zzztg/Design-of-a-Digital-Signal-Source-based-on-a-Single-chip-Microcomputer/软件工程/ad9834_test1/软件设计文档.md

# 双路同步 DDS 数字信号源 — 软件设计文档

> 基于 STM32F407VET6 + 两片 AD9834  
> 最后更新: 2026-06-03

---

## 目录

1. [系统概述](#1-系统概述)
2. [硬件资源映射](#2-硬件资源映射)
3. [软件架构](#3-软件架构)
4. [数据结构设计](#4-数据结构设计)
5. [模块详细设计](#5-模块详细设计)
6. [主循环流程](#6-主循环流程)
7. [双路同步机制](#7-双路同步机制)
8. [接口说明](#8-接口说明)

---

## 1. 系统概述

### 1.1 功能定义

双通道独立可调的数字信号源，支持：

- **频率**：1 Hz ~ 10 MHz，步进 1 Hz ~ 1 MHz（按位编辑）
- **幅值**：±18 V（用 mV 表示），步进 10 mV ~ 10 V
- **相位**：0.0° ~ 360.0°，精度 0.1°
- **波形**：正弦波、三角波、方波
- **通道模式**：单独调 A、单独调 B、同时调 AB

### 1.2 硬件拓扑

```
                        ┌─ AD9834_A (CS_A = PB12)
SPI2 (共享总线) ────────┼─ AD9834_B (CS_B = PB11)
                        └─ DAC      (CS_DAC = PB10)
                               ↑ 幅值控制（待实现）

SYNC_RESET (PB14) ──────── 两片 AD9834 的 RESET 引脚（共用）
```

AD9834 两片共用 SPI2 总线，通过各自的 CS 片选区分。  
SYNC_RESET 引脚同时接两片 AD9834 的硬件 RESET，用于同步启动。

---

## 2. 硬件资源映射

| 外设 | 功能 | 引脚 | CubeMX 配置 |
|---|---|---|---|
| **SPI2** | AD9834 + DAC 通信 | PB13(SCK), PB15(MOSI) | 主机、全双工 |
| **TIM1** | 编码器 3 — 相位调节 | PE9(CH1), PE11(CH2) | 编码器模式 |
| **TIM2** | 编码器 1 — 频率调节 | PA0(CH1), PA1(CH2) | 编码器模式 |
| **TIM3** | 编码器 2 — 幅值调节 | PB4(CH1), PB5(CH2) | 编码器模式 |
| **USART1** | printf 调试输出 | PA9(TX), PA10(RX) | 异步 115200 |

### GPIO 引脚分配

| 标签 | 引脚 | 方向 | 用途 |
|---|---|---|---|
| CS_A | PB12 | 输出 | AD9834_A 片选 |
| CS_B | PB11 | 输出 | AD9834_B 片选 |
| CS_DAC | PB10 | 输出 | DAC 片选 |
| SYNC_RESET | PB14 | 输出 | 两片 AD9834 同步复位 |
| WAVE_SEL_A | PC10 | 输出 | A 路波形选择（方波=高） |
| WAVE_SEL_B | PC11 | 输出 | B 路波形选择（方波=高） |
| KEY_ENC1 | PD0 | 输入 | 频率编码器按键 |
| KEY_ENC2 | PD1 | 输入 | 幅值编码器按键 |
| KEY_ENC3 | PD2 | 输入 | 相位编码器按键 |
| KEY_SW1 | PD3 | 输入 | 通道切换 |
| KEY_SW2 | PD4 | 输入 | 波形切换 |

---

## 3. 软件架构

### 3.1 分层结构

```
┌──────────────────────────────────────┐
│            main.c (主循环)            │  ← 应用层
│  ┌──────────┬──────────┬──────────┐   │
│  │ 编码器驱动│ 按键驱动  │ 状态管理  │   │
│  └────┬─────┴────┬─────┴────┬─────┘   │
│       │          │          │         │
│  ┌────▼──────────▼──────────▼─────┐   │
│  │       UpdateDDS / UpdateAmp     │   │  ← 硬件更新层
│  └────┬──────────┬──────────┬─────┘   │
├───────┼──────────┼──────────┼─────────┤
│  ┌────▼────┐ ┌───▼────┐ ┌──▼──────┐  │  ← BSP/驱动层
│  │ AD9834  │ │  DAC   │ │   HAL   │  │
│  │ BSP驱动 │ │ (待实现)│ │  库函数  │  │
│  └─────────┘ └────────┘ └─────────┘  │
└──────────────────────────────────────┘
```

### 3.2 设计思想

**数据驱动的脏标记机制**：

```
旋钮/按键  →  修改 g_state (内存)  →  置脏标记
                                          ↓
主循环 Step5  →  检查脏标记  →  批量同步到硬件
```

- 人机交互只修改内存中的 `g_state`，不直接操作硬件
- 脏标记记录哪些参数被修改过
- 每轮循环末尾统一同步硬件，避免频繁 SPI 通信

---

## 4. 数据结构设计

### 4.1 核心结构体层次

```
system_state_t  (全局状态)
├── selected_ch     目标通道 (A/B/BOTH)
├── wave_type       当前波形
├── ch_a            通道 A 参数
│   ├── frequency_hz   频率 (Hz)
│   ├── amplitude_mv   幅值 (mV)
│   └── phase_x10      相位 (×0.1°)
├── ch_b            通道 B 参数 (同上)
├── digit_idx[3]    三个编码器当前编辑位
│   ├── [0] 频率 digit
│   ├── [1] 幅值 digit
│   └── [2] 相位 digit
└── flags           脏标记
    ├── freq_dirty    频率已修改
    ├── amp_dirty     幅值已修改
    ├── phase_dirty   相位已修改
    └── wave_dirty    波形已修改
```

### 4.2 编码器数据结构

```c
typedef struct {
    TIM_HandleTypeDef *tim;     // 绑定的定时器
    int16_t last_counter;       // 上次采样计数值
} encoder_t;
```

### 4.3 按键数据结构

```c
typedef struct {
    uint16_t pin;               // GPIO 引脚
    GPIO_TypeDef *port;         // GPIO 端口
    btn_state_t state;          // 消抖状态 (空闲/消抖中/已按下)
    uint32_t last_tick;         // 进入消抖状态的时间戳
} button_t;
```

### 4.4 枚举定义

| 枚举 | 值 | 含义 |
|---|----|---|
| `TARGET_CH_A` | 0 | 仅调节通道 A |
| `TARGET_CH_B` | 1 | 仅调节通道 B |
| `TARGET_CH_BOTH` | 2 | 同时调节两路 |
| `AD9834_WaveSine` | 0 | 正弦波 |
| `AD9834_WaveTriangle` | 1 | 三角波 |
| `AD9834_WaveSineWithSquare` | 2 | 方波 |
| `BTN_IDLE` | 0 | 按键空闲 |
| `BTN_DEBOUNCE` | 1 | 按键消抖中 |
| `BTN_PRESSED` | 2 | 按键已按下 |

---

## 5. 模块详细设计

### 5.1 编码器读取 (`Encoder_ReadDelta`)

**原理**：定时器配置为编码器模式后，计数器会随旋钮转动自动增减。

```
输入: encoder_t *enc
输出: +1(正转一格), -1(反转一格), 0(无转动)

流程:
  1. current = TIM->CNT            // 读当前计数值
  2. raw = current - last_counter  // 计算差值
  3. 更新 last_counter = current
  4. 16位回绕修正 (±65536)
  5. 死区处理: |raw| < 2 → 0      // 过滤抖动
  6. 归一化: raw > 0 → +1, else → -1
```

### 5.2 按键消抖 (`Button_Scan`)

使用三态状态机，每轮主循环调用一次。

```
状态图:

     ┌──────────────────────────────────────┐
     │                                       │
     ▼    (检测到按下)     (10ms后仍按下)     │
  IDLE ──────────────→ DEBOUNCE ──────────→ PRESSED
     ↑                    │                    │
     │    (抖动释放)       │                    │  (检测到释放)
     └────────────────────┘                    │
              (回到 IDLE)                      │
                                               ▼
                                          触发 EVT_PRESS
                                          回到 IDLE
```

**防抖动设计**：进入 DEBOUNCE 后记录当前 tick，满 10ms 再确认。期间如果电平变高（释放），认为是抖动，退回 IDLE。

### 5.3 按位编辑 (`AdjustFrequency/Amplitude/Phase`)

**按位编辑概念**：每个参数有多个"位"（digit），旋钮每转一格，只改变选中位的值。

```
频率 digit 与步进对应：
  digit 0 → 1 Hz       digit 4 → 10 kHz
  digit 1 → 10 Hz      digit 5 → 100 kHz
  digit 2 → 100 Hz     digit 6 → 1 MHz
  digit 3 → 1 kHz

示例：
  当前频率 = 1,234,567 Hz  digit = 3 (kHz位)  正转 1 格
  → 1,234,567 + 1,000 = 1,235,567 Hz

  当前频率 = 1,999,999 Hz  digit = 5 (100kHz位)  正转 1 格
  → 1,999,999 + 100,000 = 2,099,999 Hz  (自动进位)
```

**幅值 digit**：0=10mV, 1=100mV, 2=1V, 3=10V  
**相位 digit**：0=0.1°, 1=1°, 2=10°, 3=100°

每次调整后做限幅检查，防止越界。

### 5.4 通道屏蔽机制

主循环中通过比特位掩码决定哪些通道响应调节：

```c
// selected_ch → 掩码
BOTH (2) → 掩码 = 0x03   (bit0=A路, bit1=B路)
CH_A (0) → 掩码 = 0x01   (仅 A 路)
CH_B (1) → 掩码 = 0x02   (仅 B 路)

if (mask & 0x01) { /* 调 A 路的参数 */ }
if (mask & 0x02) { /* 调 B 路的参数 */ }
```

### 5.5 DAC 幅值控制（伪代码）

当前为占位注释，待具体 DAC 型号确定后实现：

```
幅值映射: 0~18000mV → 12bit DAC 值 0~4095
  dac_value = abs(amplitude_mv) × 4095 / 18000

通信方式: 共用 SPI2，片选 CS_DAC (PB10)

极性控制: 振幅为负时切换 PGA 极性引脚
  POL_x = (amplitude_mv < 0) ? SET : RESET
```

---

## 6. 主循环流程

```
系统启动
  │
  ├─ HAL_Init()
  ├─ SystemClock_Config()         // 168MHz
  ├─ MX_GPIO_Init()               // GPIO 初始化
  ├─ MX_SPI2_Init()               // SPI 初始化 (21 MBit/s)
  ├─ MX_USART1_UART_Init()        // 串口 (printf)
  ├─ MX_TIM1_Init() ~ MX_TIM3_Init()  // 编码器定时器
  │
  ├─ AD9834_Init()                // 两片 AD9834
  ├─ 启动 TIM 编码器模式
  ├─ 设置系统初始状态
  ├─ UpdateDDS()                  // 第一次同步写入
  │
  └─ while(1) 主循环 ──────────────────────┐
       │                                     │
       ├─ Step1: 读三个编码器增量             │
       │   df = Encoder_ReadDelta(g_enc_freq)│
       │   da = Encoder_ReadDelta(g_enc_amp) │
       │   dp = Encoder_ReadDelta(g_enc_phase)│
       │                                     │
       ├─ Step2: 编码器按键 → 切换编辑位       │
       │   digit_idx[i] = (digit_idx[i]+1)%N  │
       │                                     │
       ├─ Step3: 独立按键                    │
       │   KEY_SW1 → 切换通道 (A/B/BOTH)     │
       │   KEY_SW2 → 切换波形 (Sin/Tri/Sqr)  │
       │                                     │
       ├─ Step4: 旋转 → 调参                 │
       │   if (mask & ch) AdjustParam(...)   │
       │   同时置相应的脏标记                  │
       │                                     │
       ├─ Step5: 硬件同步                    │
       │   UpdateDDS(&g_state)              │
       │   UpdateAmplitude(&g_state)         │
       │                                     │
       └─ HAL_Delay(10) ← 每 10ms 一圈        │
         (约 100 Hz 轮询频率)                  │
                                              │
         └────────────────────────────────────┘
```

---

## 7. 双路同步机制

### 7.1 为什么需要同步

两片 AD9834 各自独立工作。如果没有同步机制，各自从随机相位开始输出，两路信号之间会有不确定的相位差。

### 7.2 同步方法

利用 AD9834 的 **硬件 RESET 引脚**（两片共用 SYNC_RESET）：

```
时间轴:

  SYNC_RESET ────────┬── 高电平 ──┬── 低电平 ──────────
                     │            │
  AD9834_A 状态    停止(相位=0)  开始输出
  AD9834_B 状态    停止(相位=0)  开始输出 (同时!)
                     │            │
                     │  在此区间  │
                     │  写入频率  │
                     │  写入相位  │
                     │  写入波形  │
```

### 7.3 代码实现

```c
void UpdateDDS(system_state_t *state)
{
    // 没有任何更新需要 → 跳过
    if (!state->flags.freq_dirty && !state->flags.phase_dirty && !state->flags.wave_dirty)
        return;

    // Step 1: 拉高 SYNC_RESET，两片同时停止，相位累积器归零
    HAL_GPIO_WritePin(SYNC_RESET_GPIO_Port, SYNC_RESET_Pin, GPIO_PIN_SET);

    // Step 2: 通过 SPI 分别写入两片 AD9834
    if (state->flags.wave_dirty)  { /* 写波形到 A 和 B */ }
    if (state->flags.freq_dirty)  { /* 写频率到 A 和 B */ }
    if (state->flags.phase_dirty) { /* 写相位到 A 和 B */ }

    // Step 3: 拉低 SYNC_RESET，两片同时从相位 0 开始输出
    HAL_GPIO_WritePin(SYNC_RESET_GPIO_Port, SYNC_RESET_Pin, GPIO_PIN_RESET);
}
```

### 7.4 同步时机

仅在频率或相位发生变化时触发同步。波形切换不影响相位累积器，但为了实现统一管理，当前实现在任意 DDS 参数变化时都做同步。

---

## 8. 接口说明

### 8.1 BSP 驱动接口 (`BSP/ad9834.h`)

参考 [ad9834.h](../BSP/ad9834.h)。

| 函数 | 参数 | 说明 |
|---|---|---|
| `AD9834_Init` | self, hspi, cs_pin, cs_port | 初始化 AD9834 实例 |
| `AD9834_SetReset` | self, reset | 软件复位/释放 |
| `AD9834_SetFrequency` | self, freg, frequency | 写频率寄存器 |
| `AD9834_SetPhase` | self, preg, angle | 写相位寄存器 |
| `AD9834_SelectFrequencyRegOutput` | self, fsel | 选择输出频率寄存器 |
| `AD9834_SelectPhaseRegOutput` | self, psel | 选择输出相位寄存器 |
| `AD9834_SetOutputWave` | self, wave | 设置输出波形 |

### 8.2 内部模块接口 (`main.c`)

| 函数 | 作用域 | 说明 |
|---|---|---|
| `Encoder_ReadDelta` | static | 读取编码器转动增量 |
| `Button_Scan` | static | 按键消抖扫描 |
| `AdjustFrequency` | static | 按位调节频率 |
| `AdjustAmplitude` | static | 按位调节幅值 |
| `AdjustPhase` | static | 按位调节相位 |
| `SetWaveformGPIO` | static | 控制波形选择 GPIO |
| `UpdateDDS` | static | 更新 AD9834（含同步） |
| `UpdateAmplitude` | static | 更新 DAC 幅值（伪代码） |

### 8.3 全局变量

| 变量 | 类型 | 用途 |
|---|---|---|
| `g_ad9834_a` | ad9834_t | A 路 AD9834 实例 |
| `g_ad9834_b` | ad9834_t | B 路 AD9834 实例 |
| `g_enc_freq` | encoder_t | 频率编码器 (TIM2) |
| `g_enc_amp` | encoder_t | 幅值编码器 (TIM3) |
| `g_enc_phase` | encoder_t | 相位编码器 (TIM1) |
| `g_btn_freq/amp/phase` | button_t | 编码器按键（切换 digit） |
| `g_btn_ch/wave` | button_t | 独立按键（切换通道/波形） |
| `g_state` | system_state_t | 系统运行状态 |

---

> **附录**：DAC 驱动和 TFT 显示当前为待实现状态，相关代码以伪代码注释形式存在于 `main.c` 中。
