zzztg/Design-of-a-Digital-Signal-Source-based-on-a-Single-chip-Microcomputer/硬件电路/STM32控制.pdf

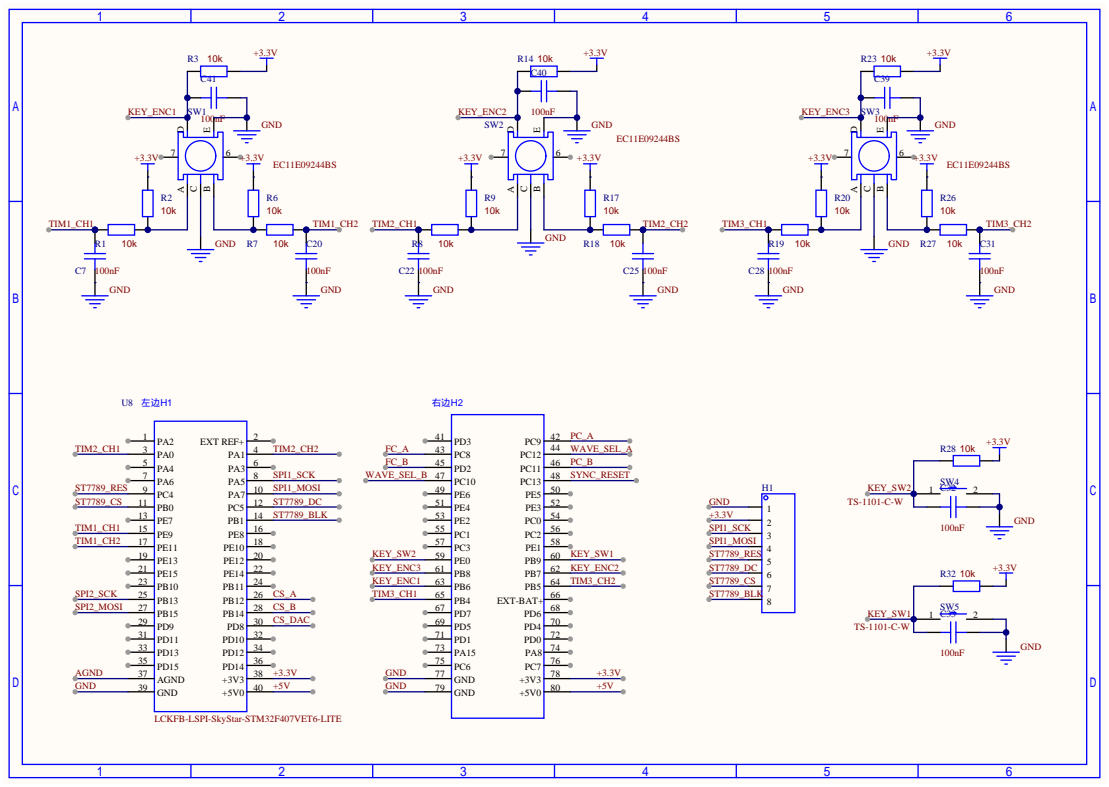
[picture p58: page 1]

LCKFB-LSPI-SkyStar-STM32F407VET6-LITE
