zzztg/Design-of-a-Digital-Signal-Source-based-on-a-Single-chip-Microcomputer/硬件电路/ad9834调理及功放.pdf

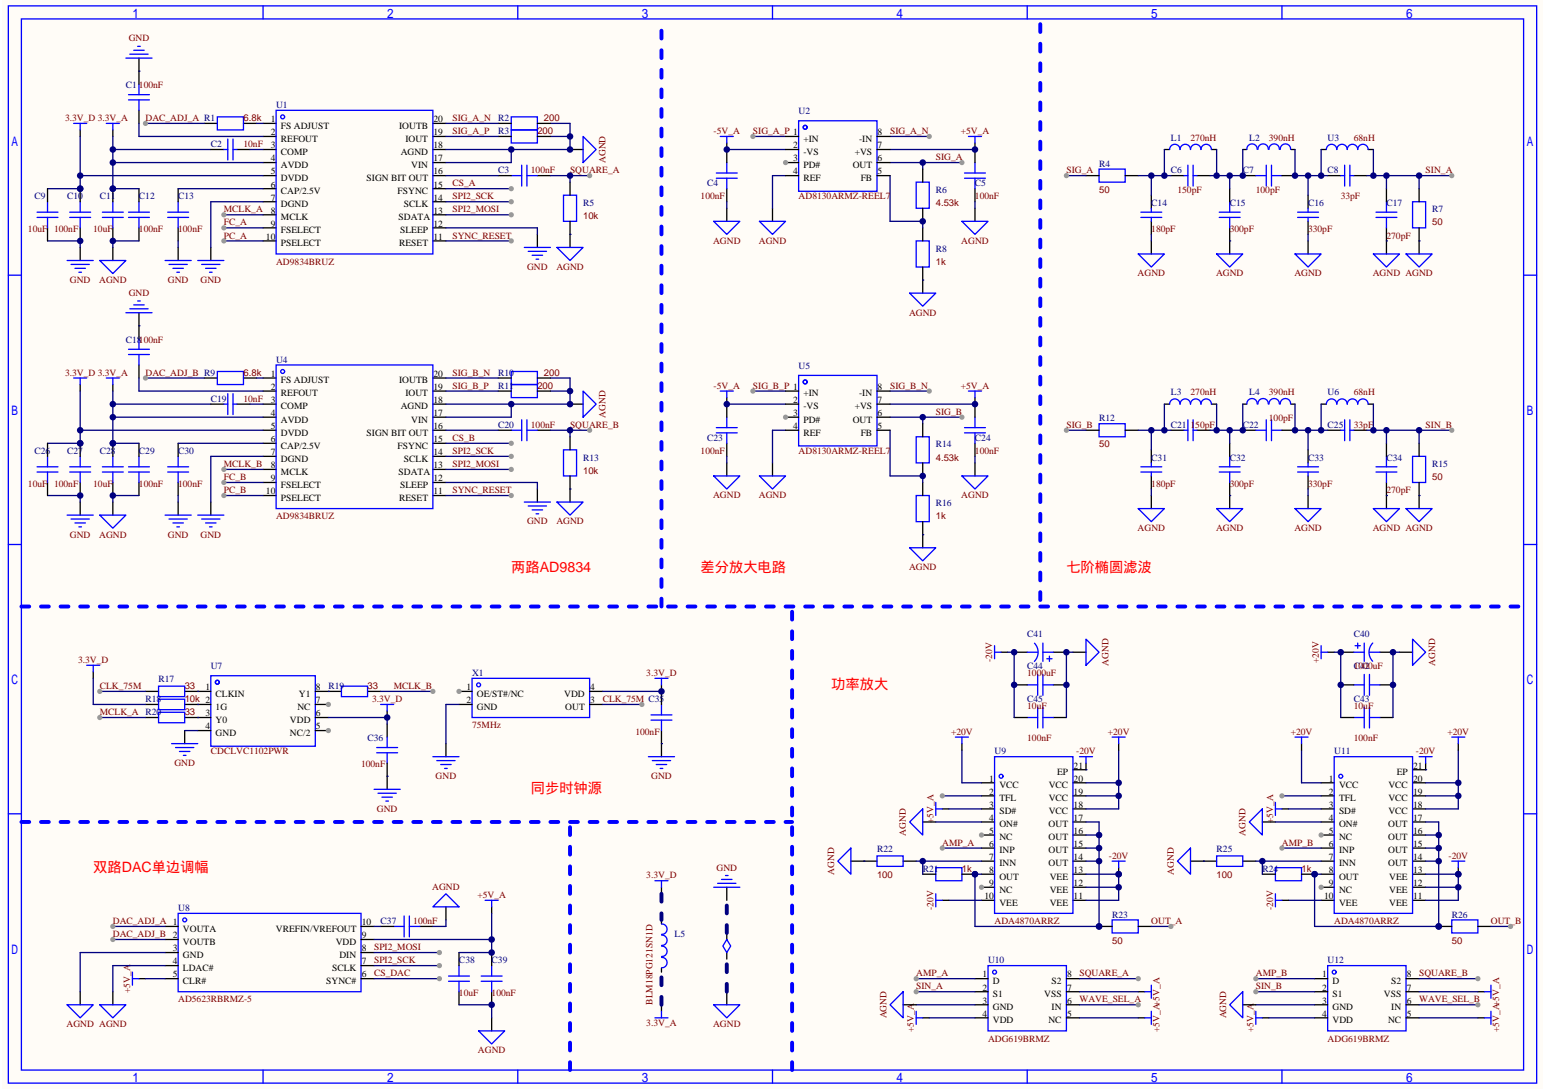
[picture p59: page 1]
