zzztg/Design-of-a-Digital-Signal-Source-based-on-a-Single-chip-Microcomputer/仿真设计/全链路仿真.asc

C1: cap; 180p
C2: cap; 150p
C3: cap; 300p
C4: cap; 100p
C5: cap; 330p
C6: cap; 33p
C7: cap; 270p
C8: cap; 0.1µ
L1: ind; 270n; Rser=1m
L2: ind; 390n; Rser=1m
L3: ind; 470n; Rser=1m
R1: res; 4.53k
R2: res; 1k
R3: res; 50
R4: res; 50
R5: res; 10k
R6: res; 100
R7: res; 1k
R8: res; 50
U1: AD8130
U2: ADG619
U3: ADA4870
V1: voltage; SINE(0.3 0.3 10Meg); AC 1
V2: voltage; SINE(0.3 0.3 10Meg 0 0 180); AC 1 180
V3: voltage; 5
V4: voltage; -5
V5: voltage; PULSE(0 3.3 0 1n 1n 49n 100n)
V6: voltage; 5
V7: voltage; 5
V8: voltage; PULSE(0 3 0 1n 1n 2u 4u)
V9: voltage; 20
V10: voltage; -20
V11: voltage; -15
Named nets: 0, IN+, IN-, OUT, SIN_OUT, Vin, PULSE_IN, PULSE_OUT, +V, -V, _SD, BNC_OUT
.tran 5u
