zzztg/Design-of-a-Digital-Signal-Source-based-on-a-Single-chip-Microcomputer/仿真设计/大功率终级输出测试.asc

R1: res; 100
R2: res; 1k
R3: res; 50
U1: ADG619
U2: ADA4870
V1: voltage; 5
V2: voltage; 5
V3: voltage; SINE(0 1.65 10Meg)
V4: voltage; 20
V6: voltage; -20
V7: voltage; -15
Named nets: 0, +V, -V, _SD, BNC_OUT
.tran 2u
