zzztg/Design-of-a-Digital-Signal-Source-based-on-a-Single-chip-Microcomputer/仿真设计/方波链路的交流耦合与稳态响应仿真.asc

C1: cap; 0.1µ
R1: res; 10k
V1: voltage; PULSE(0 3.3 0 1n 1n 49n 100n)
Named nets: 0, IN, OUT
.tran 3m
