zzztg/Design-of-a-Digital-Signal-Source-based-on-a-Single-chip-Microcomputer/仿真设计/正弦波预补偿与滤波链路测试.asc

C1: cap; 180p
C2: cap; 150p
C3: cap; 300p
C4: cap; 100p
C5: cap; 330p
C6: cap; 33p
C7: cap; 270p
L1: ind; 270n; Rser=1m
L2: ind; 390n; Rser=1m
L3: ind; 470n; Rser=1m
R1: res; 4.53k
R2: res; 1k
R3: res; 50
R4: res; 50
U1: AD8130
V1: voltage; SINE(0.3 0.3 10Meg); AC 1
V2: voltage; SINE(0.3 0.3 10Meg 0 0 180); AC 1 180
V3: voltage; 5
V4: voltage; -5
Named nets: 0, IN+, IN-, OUT, Vout, Vin
.tran 1u
.ac dec 1000 1Meg 65Meg
