zzztg/Design-of-a-Digital-Signal-Source-based-on-a-Single-chip-Microcomputer/仿真设计/滤波链路.asc

C1: cap; 180p
C2: cap; 150p
C3: cap; 300p
C4: cap; 100p
C5: cap; 330p
C6: cap; 33p
C7: cap; 270p
L1: ind; 270n; Rser=1m
L2: ind; 390n; Rser=1m
L3: ind; 68n; Rser=1m
R1: res; 50
R2: res; 50
V1: voltage; SINE(3.3 0 1Meg); AC 1
Named nets: 0, Vout, Vin
.ac dec 1000 1 75Meg
