zzztg/Design-of-a-Digital-Signal-Source-based-on-a-Single-chip-Microcomputer/软件工程/ad9834_test1/Core/Inc/main.h

#define CS_DAC_Pin GPIO_PIN_10
#define CS_DAC_GPIO_Port GPIOB
#define CS_B_Pin GPIO_PIN_11
#define CS_B_GPIO_Port GPIOB
#define CS_A_Pin GPIO_PIN_12
#define CS_A_GPIO_Port GPIOB
#define SYNC_RESET_Pin GPIO_PIN_14
#define SYNC_RESET_GPIO_Port GPIOB
#define PC_A_Pin GPIO_PIN_8
#define PC_A_GPIO_Port GPIOC
#define PC_B_Pin GPIO_PIN_9
#define PC_B_GPIO_Port GPIOC
#define WAVE_SEL_A_Pin GPIO_PIN_10
#define WAVE_SEL_A_GPIO_Port GPIOC
#define WAVE_SEL_B_Pin GPIO_PIN_11
#define WAVE_SEL_B_GPIO_Port GPIOC
#define KEY_ENC1_Pin GPIO_PIN_0
#define KEY_ENC1_GPIO_Port GPIOD
#define KEY_ENC2_Pin GPIO_PIN_1
#define KEY_ENC2_GPIO_Port GPIOD
#define KEY_ENC3_Pin GPIO_PIN_2
#define KEY_ENC3_GPIO_Port GPIOD
#define KEY_SW1_Pin GPIO_PIN_3
#define KEY_SW1_GPIO_Port GPIOD
#define KEY_SW2_Pin GPIO_PIN_4
#define KEY_SW2_GPIO_Port GPIOD
#define FC_A_Pin GPIO_PIN_8
#define FC_A_GPIO_Port GPIOB
#define FC_B_Pin GPIO_PIN_9
#define FC_B_GPIO_Port GPIOB
