zzztg/Design-of-a-Digital-Signal-Source-based-on-a-Single-chip-Microcomputer/(commit log)

2026-05-29 毕业论文提交
2026-06-03 集体实现
2026-06-03 具体实现
2026-06-03 毕业论文更改
2026-06-10 答辩修改
