zzztg/Design-of-a-Digital-Signal-Source-based-on-a-Single-chip-Microcomputer/(notices)

Notices in the files:
软件工程/ad9834_test1/Core/Inc/main.h:
Copyright (c) 2026 STMicroelectronics.
All rights reserved.
This software is licensed under terms that can be found in the LICENSE file
